vladimiroltean/debugcable/USB_DebugCable.pdf

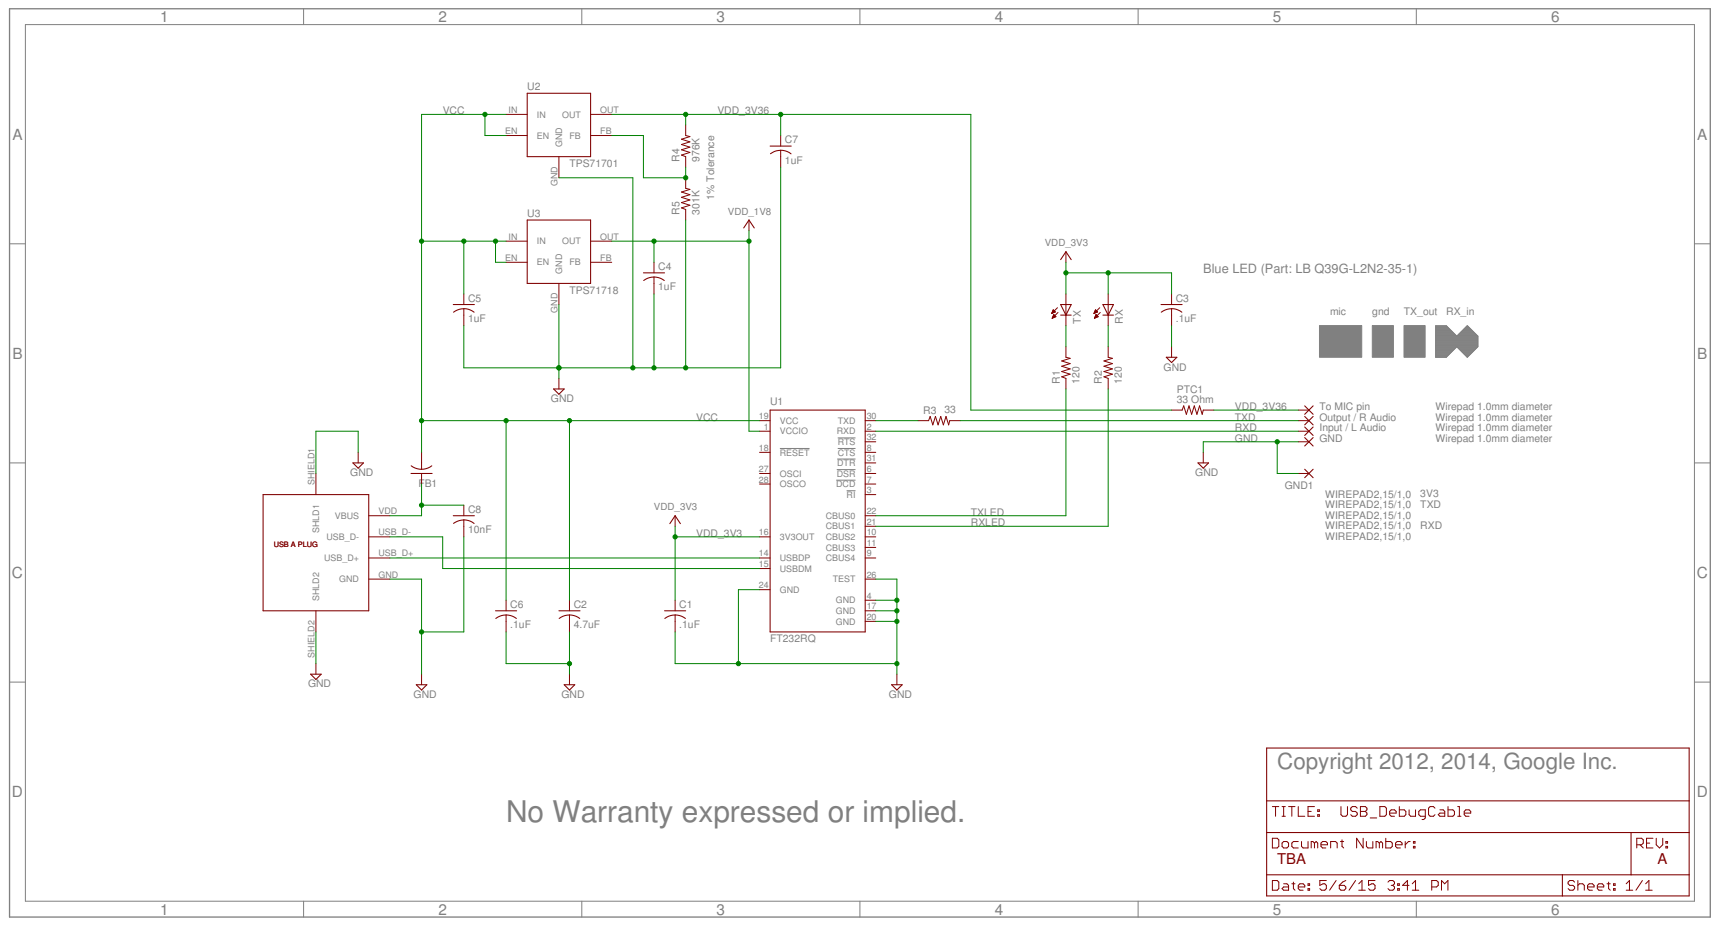
[picture p1: page 1]

Blue LED (Part: LB Q39G-L2N2-35-1)

Input / L Audio To MIC pin
Output / R Audio
GND

Wirepad 1.0mm diameter Wirepad 1.0mm diameter
