vladimiroltean/debugcable/fab/USB_DebugCable.pdf

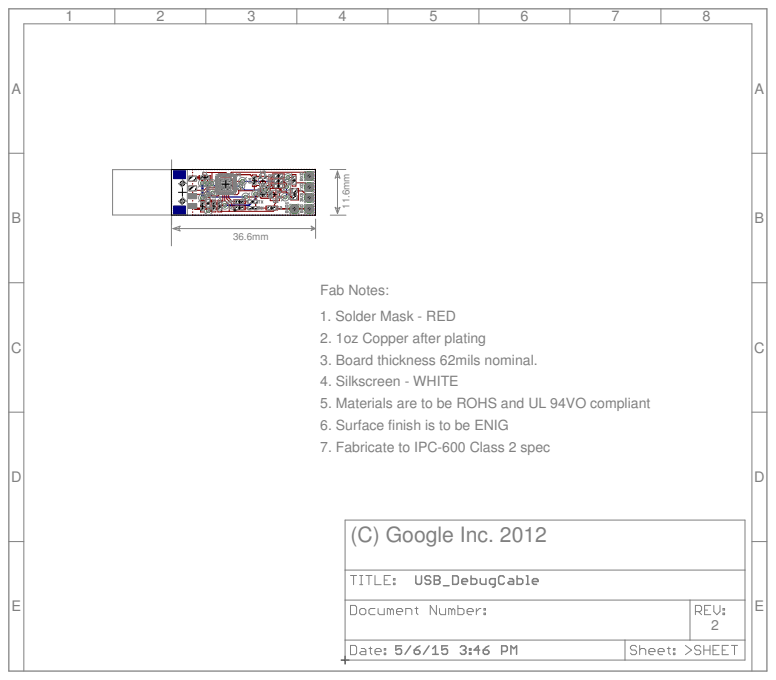
[picture p2: page 1]

Fab Notes:
1. Solder Mask - RED
2. 1oz Copper after plating
3. Board thickness 62mils nominal. 4. Silkscreen - WHITE

5. Materials are to be ROHS and UL 94VO compliant
6. Surface finish is to be ENIG
7. Fabricate to IPC-600 Class 2 spec
