vladimiroltean/debugcable/USB_DebugCable.brd

## EAGLE design USB_DebugCable.brd (2016-11-22)

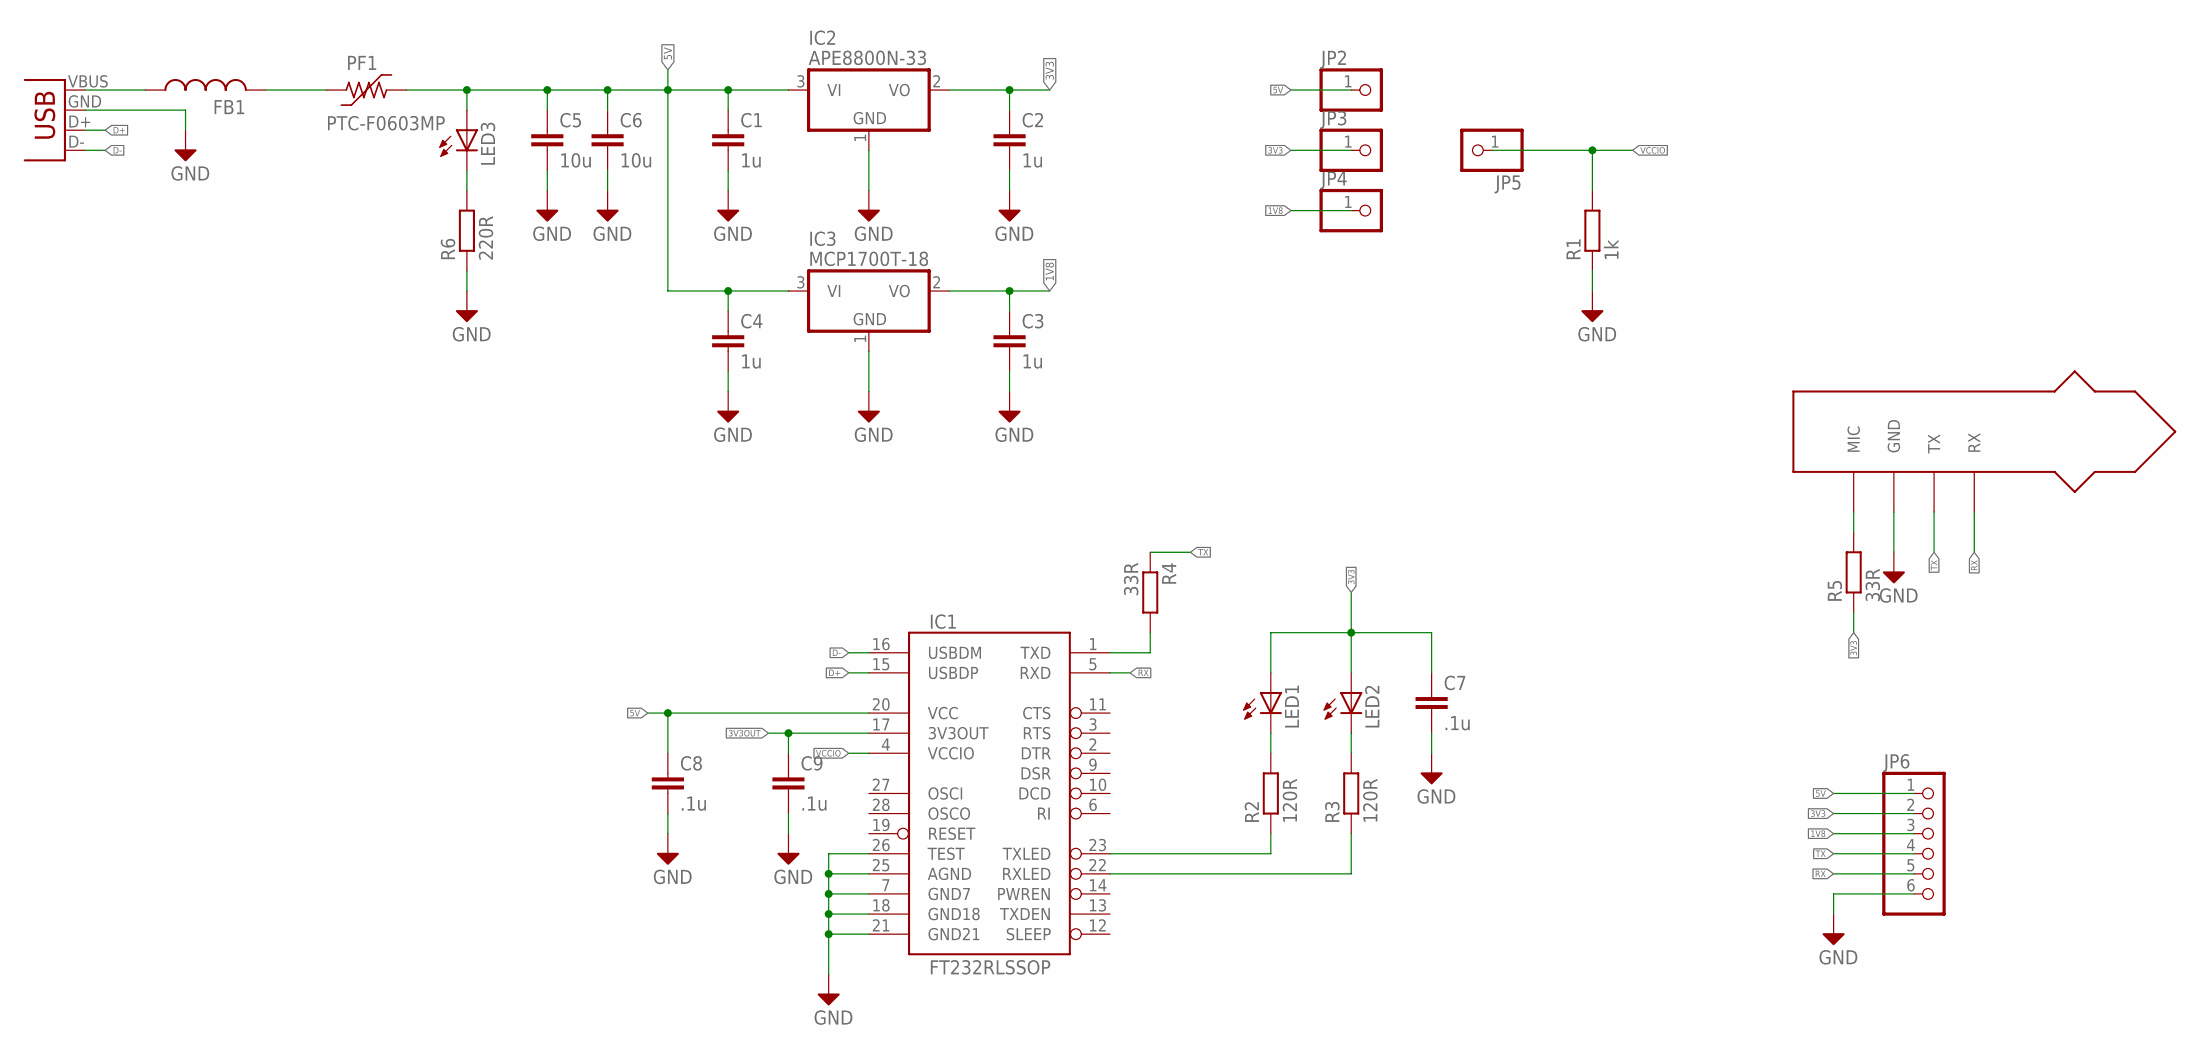
[picture p3: schematic USB_DebugCable.sch]

Parts:
C1, C2, C3, C4: 1u; C0603K
C5, C6: 10u; C0603K
C7: .1u; C0603K
C8, C9: .1u; C0402K
FB1: FERRITE-BEADA; 0603
IC1: FT232RLSSOP; SSOP28DB
IC2: APE8800N-33; SOT23
IC3: MCP1700T-18; SOT23
JP1: USB-A-H
JP2, JP3, JP4, JP5: PINHD-1X1; 1X01
JP6: PINHD-1X6CB; 1X06-CLEANBIG
LED1, LED2, LED3: LEDCHIPLED_0603; CHIPLED_0603
PF1: PTC-F0603MP; F0603MP
R1: 1k; R0603
R2, R3: 120R; R0603
R4, R5: 33R; R0603
R6: 220R; R0603
U$1: JACK3.5_4; 3.5MM4

Connections:
1V8: C3.1, IC3.2 (VO), JP4.1, JP6.3
3V3: C2.1, C7.1, IC2.2 (VO), JP3.1, JP6.2, LED1.A, LED2.A, R5.1
3V3OUT: C9.1, IC1.17 (3V3OUT)
5V: C1.1, C4.1, C5.1, C6.1, C8.1, IC1.20 (VCC), IC2.3 (VI), IC3.3 (VI), JP2.1, JP6.1, LED3.A, PF1.2
D+: IC1.15 (USBDP), JP1.D+ (D-)
D-: IC1.16 (USBDM), JP1.D- (D+)
GND: C1.2, C2.2, C3.2, C4.2, C5.2, C6.2, C7.2, C8.2, C9.2, IC1.7 (GND7), IC1.18 (GND18), IC1.21 (GND21), IC1.25 (AGND), IC1.26 (TEST), IC2.1 (GND), IC3.1 (GND), JP1.GND (VBUS), JP6.6, R1.1, R6.1, U$1.GND
unnamed: FB1.1, JP1.VBUS (GND)
unnamed: R5.2, U$1.MIC_1 (MIC), U$1.MIC_2 (MIC)
unnamed: IC1.1 (TXD), R4.2
unnamed: FB1.2, PF1.1
unnamed: IC1.23 (TXLED), R2.1
unnamed: IC1.22 (RXLED), R3.1
unnamed: LED1.C, R2.2
unnamed: LED2.C, R3.2
unnamed: LED3.C, R6.2
RX: IC1.5 (RXD), JP6.5, U$1.RX_1 (RX), U$1.RX_2 (RX)
TX: JP6.4, R4.1, U$1.TX
VCCIO: IC1.4 (VCCIO), JP5.1, R1.2

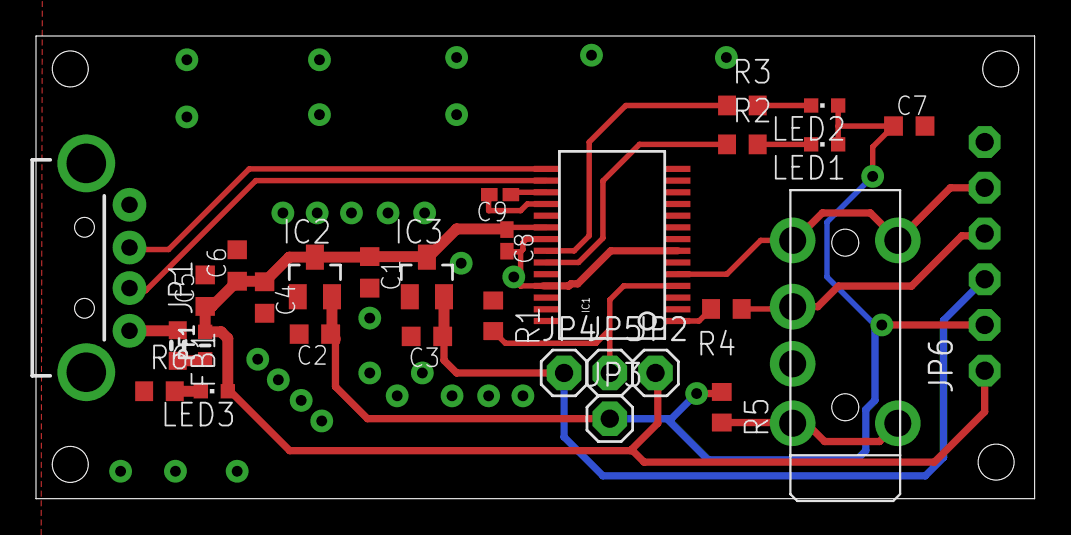
[picture p4: board USB_DebugCable.brd from above]

Board: 2 copper layers, 55.5 x 25.7 mm, 30 parts (0 on the bottom side), 19 nets.
