vladimiroltean/debugcable/(commit log)

2015-05-06 USB debug cable design documents
    Eagle schematics and PCB, gerber files, and BOM for a debug cable
    for the headset serial port found on most Nexus devices.
    [USB_DebugCable.brd, USB_DebugCable.sch, USB_DebugCable_Rev2_BOM.csv]
2016-11-22 Schematic, board and library updates
    [USB_DebugCable.brd, USB_DebugCable.sch]
