vladimiroltean/debugcable/(notices)

Notices in the files:
parts and their libraries:
SparkFun-Connectors: Licensing: CC v3.0 Share-Alike You are welcome to use this library for commercial purposes.
polyswitch: Copyright (C) 2008, Bob Starr
m-pad-2.1: License : GNU General Public License version 2 (see bottom)
